brown2rl/MRV32-Platform/Visual Aids/ALU.png

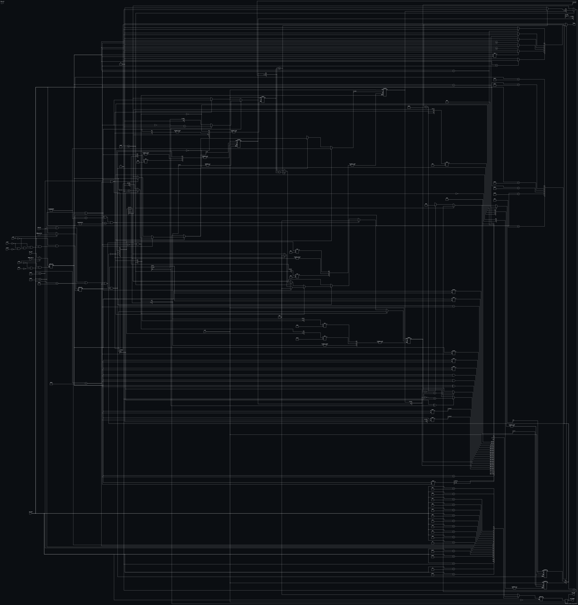
Visual Aids/ALU.png
