brown2rl/MRV32-Platform/Visual Aids/cache_state_diagram.png

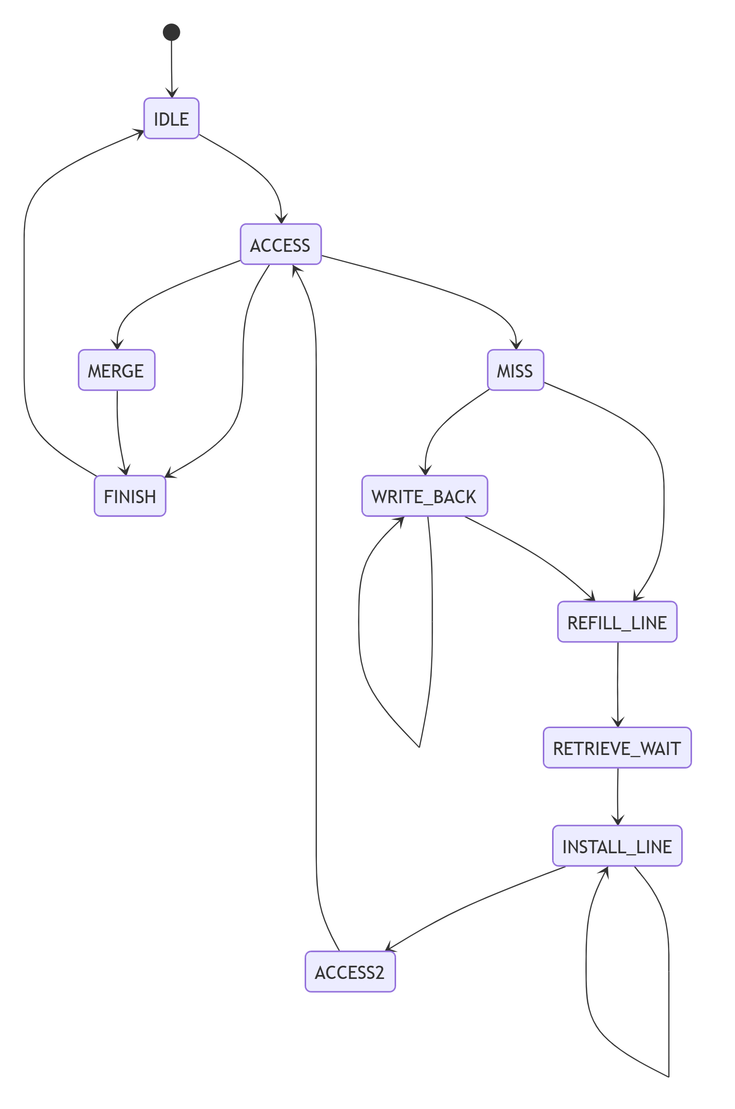
Visual Aids/cache_state_diagram.png
