brown2rl/MRV32-Platform/Visual Aids/CSR Bus.png

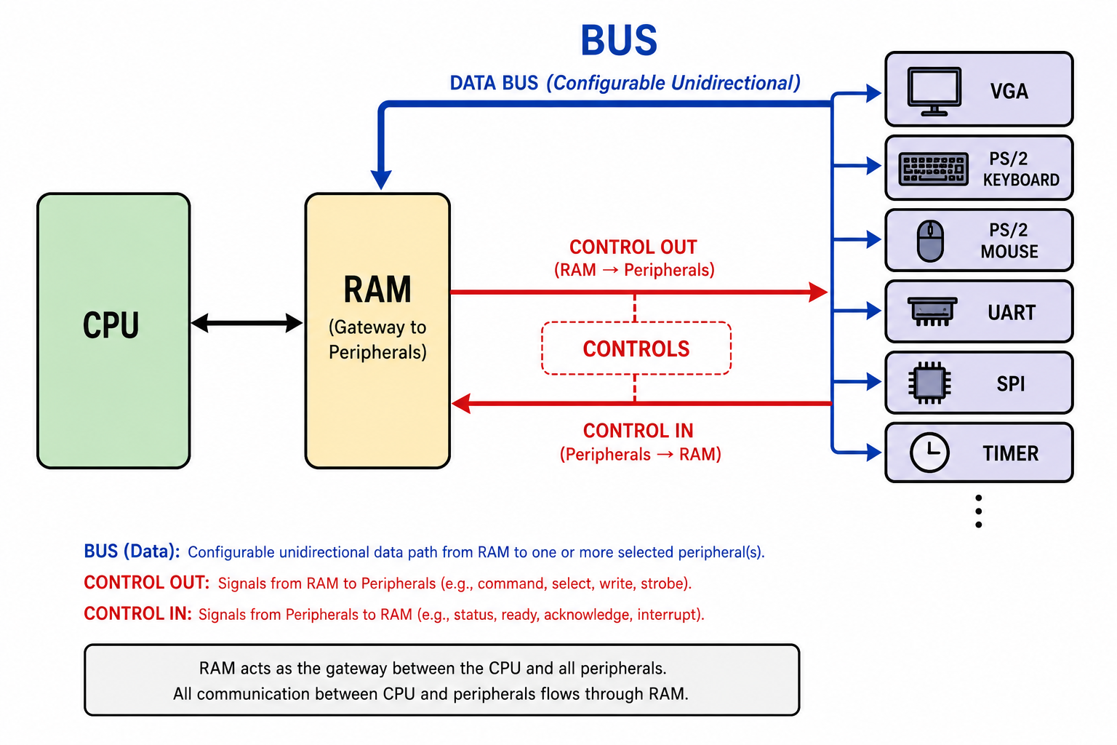
Visual Aids/CSR Bus.png
