brown2rl/MRV32-Platform/Visual Aids/MRV32 Hardware Datapath Diagram.png

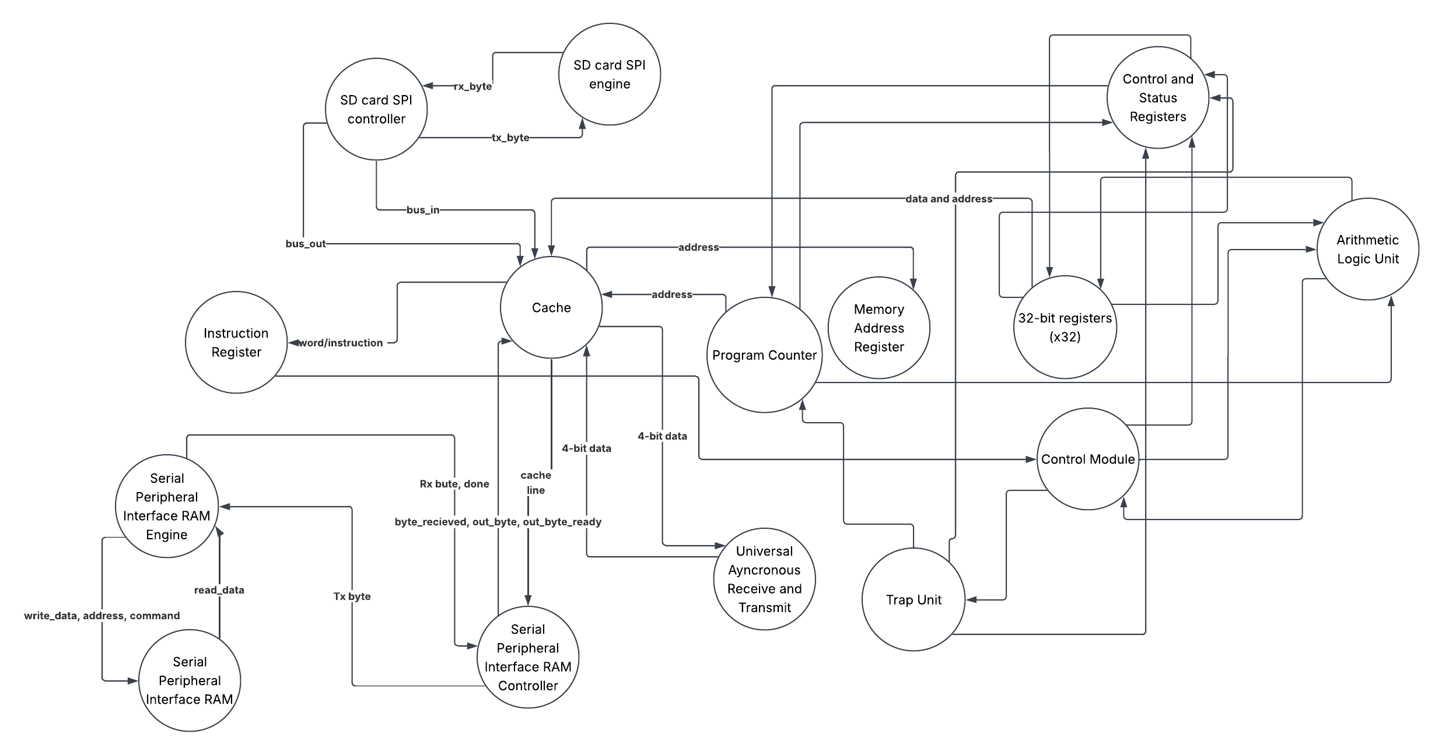
Visual Aids/MRV32 Hardware Datapath Diagram.png
