brown2rl/MRV32-Platform/Visual Aids/Normal_Fetch_Cycle.png

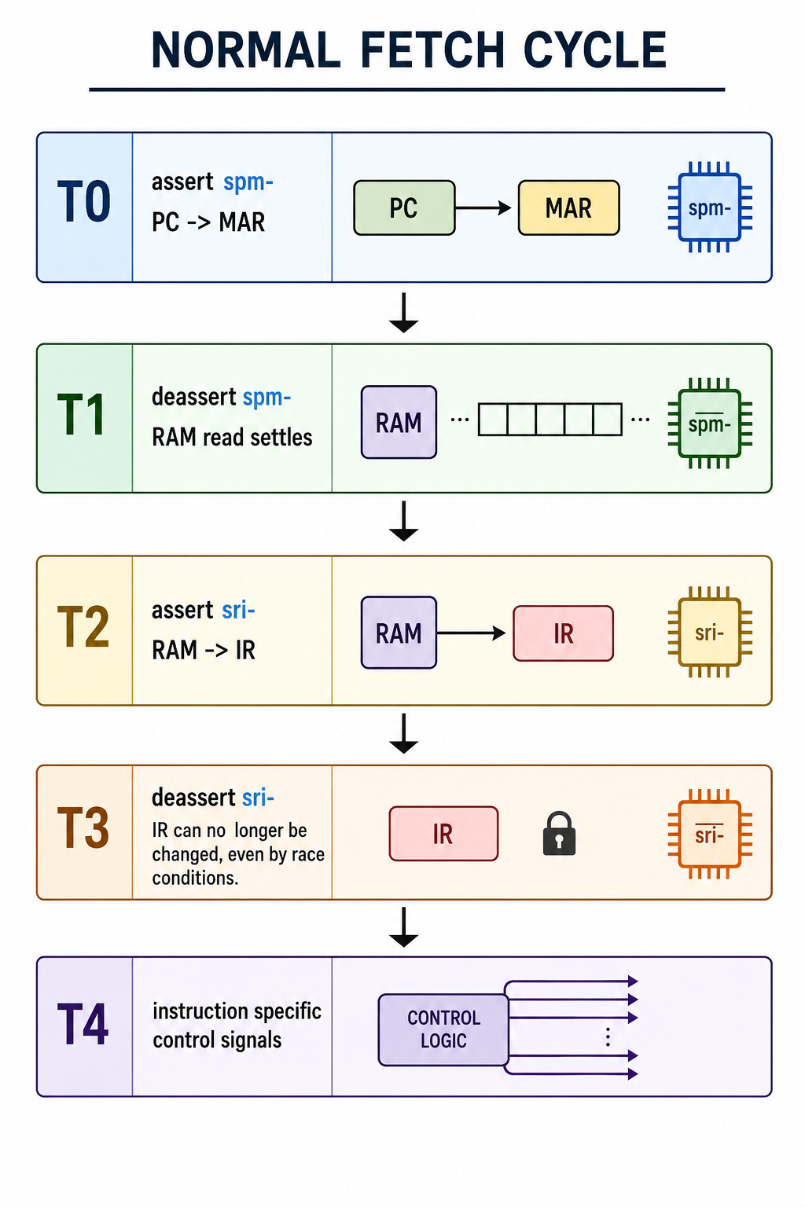
Visual Aids/Normal_Fetch_Cycle.png
