brown2rl/MRV32-Platform/Visual Aids/RISCV.png

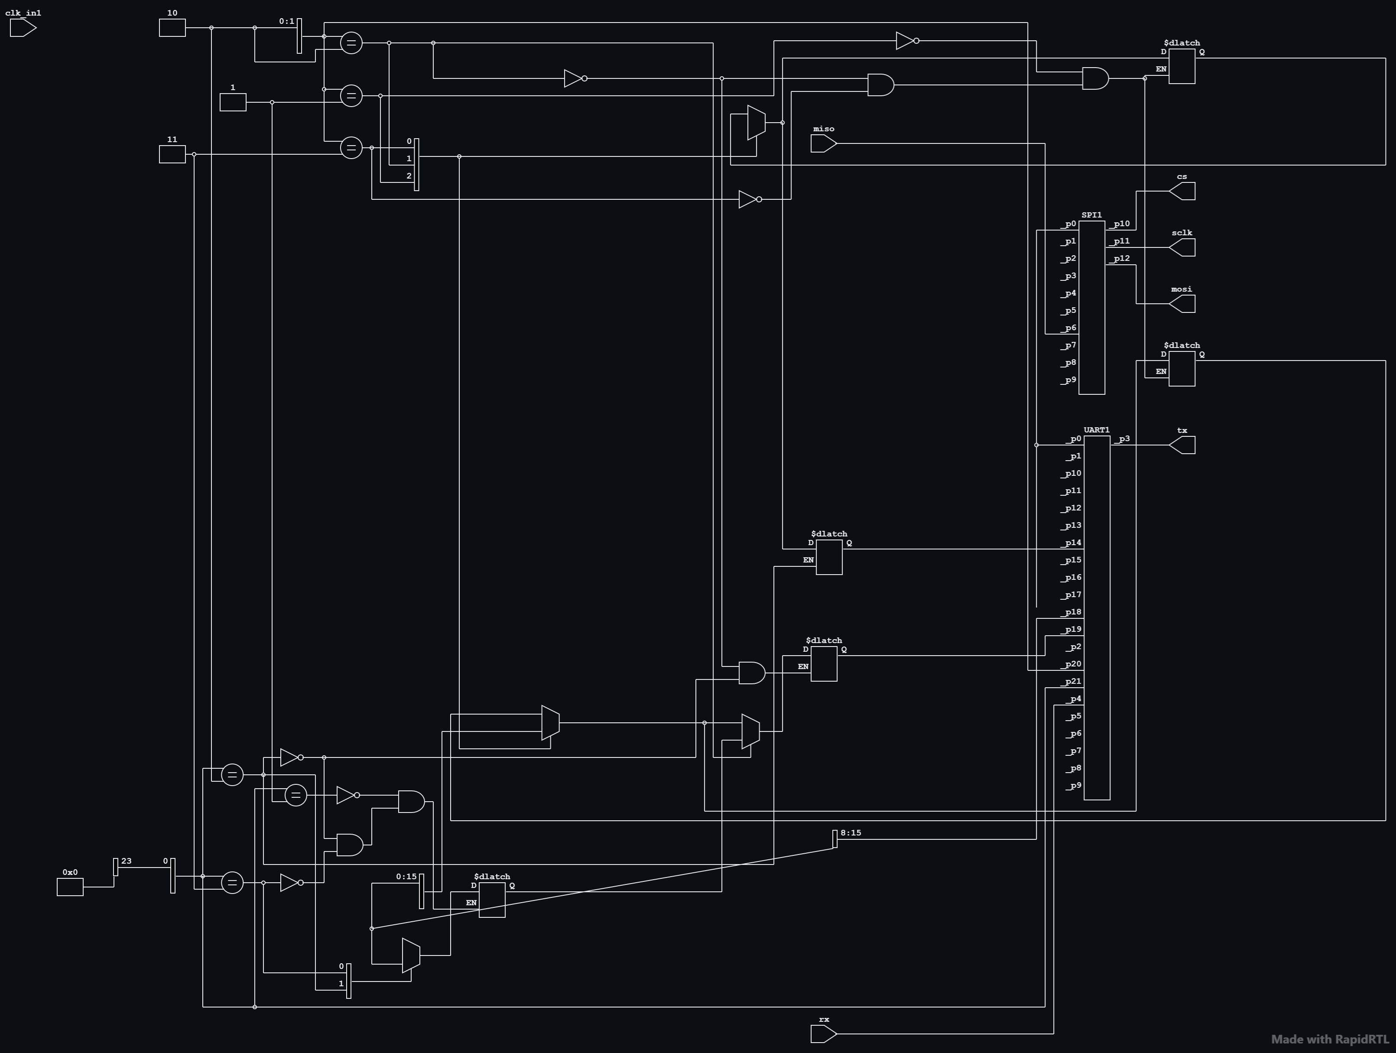
Visual Aids/RISCV.png
