brown2rl/MRV32-Platform/Visual Aids/spi_diagrams/spiram_command_decoder.png

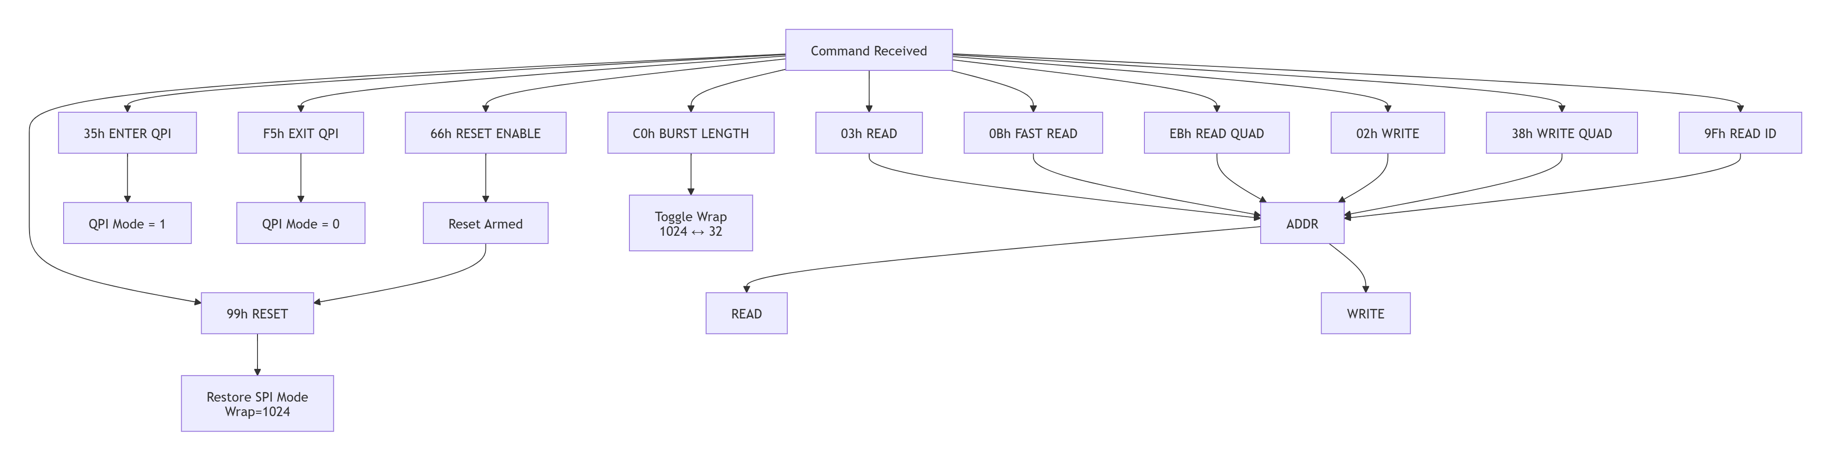
Visual Aids/spi_diagrams/spiram_command_decoder.png
