brown2rl/MRV32-Platform/Visual Aids/spi_diagrams/spiram_controller_fsm.png

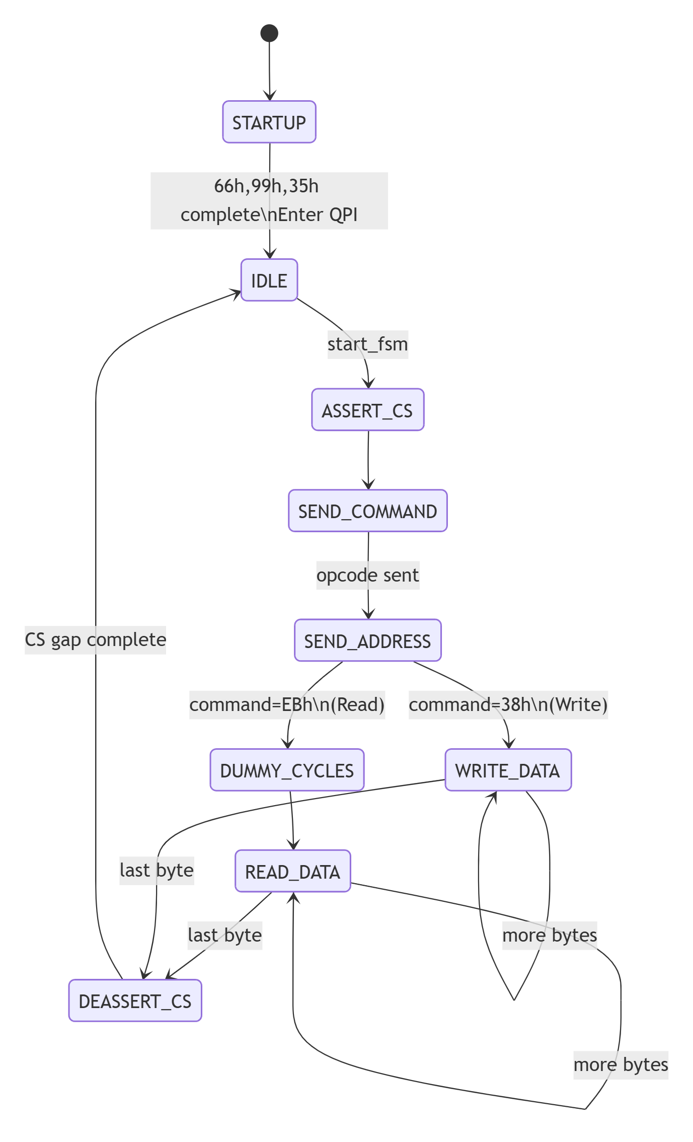
Visual Aids/spi_diagrams/spiram_controller_fsm.png
