brown2rl/MRV32-Platform/Visual Aids/spi_diagrams/spiramcontroller_dataflow.png

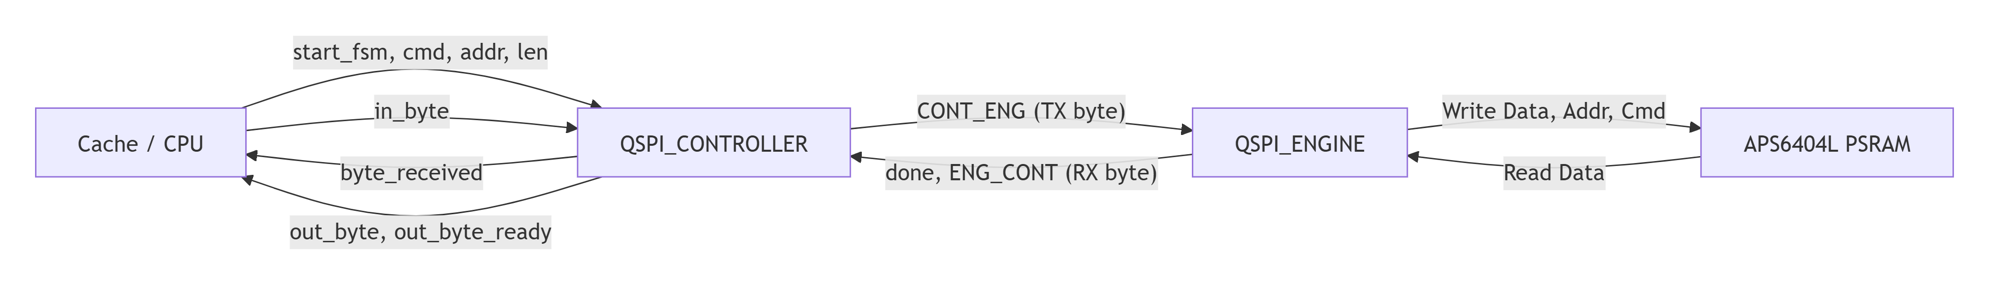
Visual Aids/spi_diagrams/spiramcontroller_dataflow.png
