brown2rl/MRV32-Platform/Visual Aids/Type_R_Instructions.png

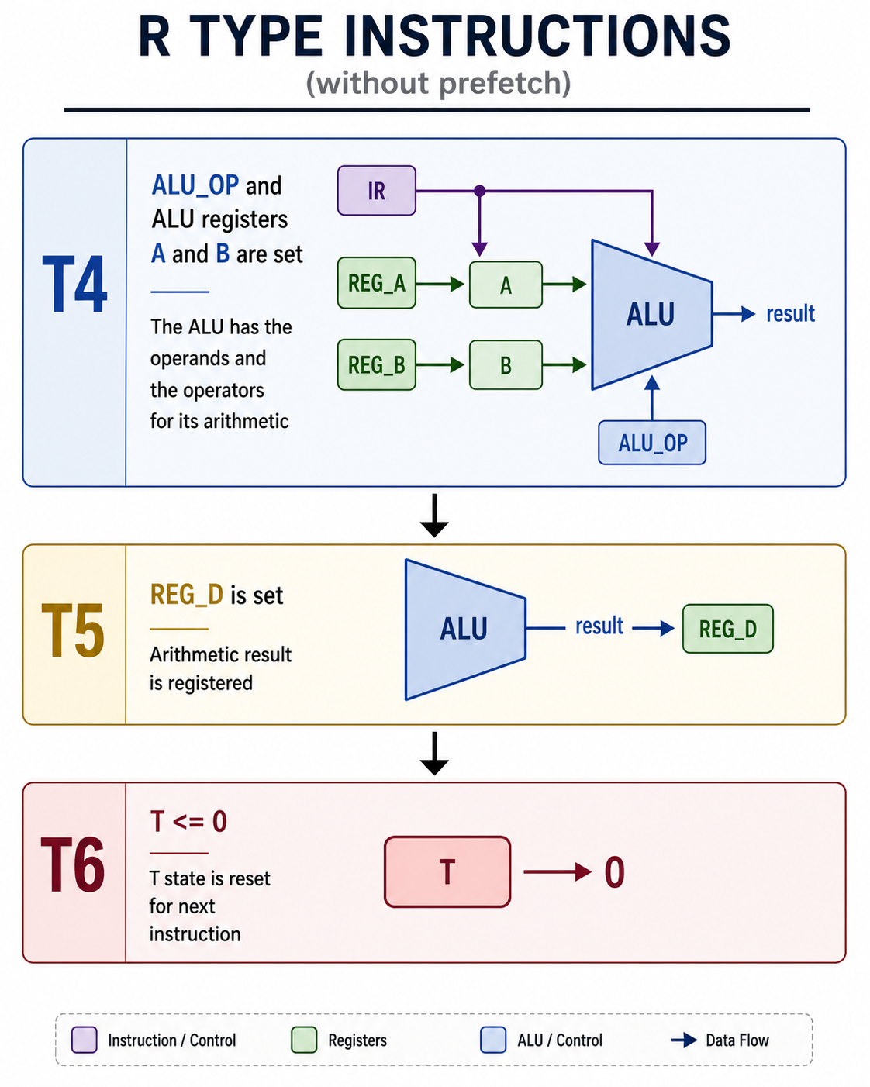
Visual Aids/Type_R_Instructions.png
