brown2rl/MRV32-Platform/Soft Core/uart_const.xdc

## This file is a general .xdc for the Basys3 rev B board
## To use it in a project:
## - uncomment the lines corresponding to used pins
## - rename the used ports (in each line, after get_ports) according to the top level signal names in the project

## Clock signal
set_property -dict {PACKAGE_PIN W5 IOSTANDARD LVCMOS33} [get_ports clk_in1]
create_clock -period 10.000 -name sys_clk_pin -waveform {0.000 5.000} -add [get_ports clk_in1]


## Switches
#set_property -dict { PACKAGE_PIN V17   IOSTANDARD LVCMOS33 } [get_ports in0]
#set_property -dict { PACKAGE_PIN V16   IOSTANDARD LVCMOS33 } [get_ports {sw[1]}]
#set_property -dict { PACKAGE_PIN W16   IOSTANDARD LVCMOS33 } [get_ports {sw[2]}]
#set_property -dict { PACKAGE_PIN W17   IOSTANDARD LVCMOS33 } [get_ports {sw[3]}]
#set_property -dict { PACKAGE_PIN W15   IOSTANDARD LVCMOS33 } [get_ports {sw[4]}]
#set_property -dict { PACKAGE_PIN V15   IOSTANDARD LVCMOS33 } [get_ports {sw[5]}]
#set_property -dict { PACKAGE_PIN W14   IOSTANDARD LVCMOS33 } [get_ports {sw[6]}]
#set_property -dict { PACKAGE_PIN W13   IOSTANDARD LVCMOS33 } [get_ports {sw[7]}]
#set_property -dict { PACKAGE_PIN V2    IOSTANDARD LVCMOS33 } [get_ports {sw[8]}]
#set_property -dict { PACKAGE_PIN T3    IOSTANDARD LVCMOS33 } [get_ports {sw[9]}]
#set_property -dict { PACKAGE_PIN T2    IOSTANDARD LVCMOS33 } [get_ports {sw[10]}]
#set_property -dict { PACKAGE_PIN R3    IOSTANDARD LVCMOS33 } [get_ports {sw[11]}]
#set_property -dict { PACKAGE_PIN W2    IOSTANDARD LVCMOS33 } [get_ports {sw[12]}]
#set_property -dict { PACKAGE_PIN U1    IOSTANDARD LVCMOS33 } [get_ports {sw[13]}]
#set_property -dict { PACKAGE_PIN T1    IOSTANDARD LVCMOS33 } [get_ports {sw[14]}]
#set_property -dict { PACKAGE_PIN R2    IOSTANDARD LVCMOS33 } [get_ports {sw[15]}]


## LEDs
set_property -dict {PACKAGE_PIN U16 IOSTANDARD LVCMOS33} [get_ports out0]
set_property -dict {PACKAGE_PIN E19 IOSTANDARD LVCMOS33} [get_ports out1]
set_property -dict {PACKAGE_PIN U19 IOSTANDARD LVCMOS33} [get_ports out2]
set_property -dict {PACKAGE_PIN V19 IOSTANDARD LVCMOS33} [get_ports out3]
set_property -dict {PACKAGE_PIN W18 IOSTANDARD LVCMOS33} [get_ports out4]
set_property -dict {PACKAGE_PIN U15 IOSTANDARD LVCMOS33} [get_ports out5]
set_property -dict {PACKAGE_PIN U14 IOSTANDARD LVCMOS33} [get_ports out6]
set_property -dict {PACKAGE_PIN V14 IOSTANDARD LVCMOS33} [get_ports out7]
set_property -dict {PACKAGE_PIN V13 IOSTANDARD LVCMOS33} [get_ports out8]
set_property -dict {PACKAGE_PIN V3 IOSTANDARD LVCMOS33} [get_ports out9]
set_property -dict {PACKAGE_PIN W3 IOSTANDARD LVCMOS33} [get_ports out10]
set_property -dict {PACKAGE_PIN U3 IOSTANDARD LVCMOS33} [get_ports out11]
set_property -dict {PACKAGE_PIN P3 IOSTANDARD LVCMOS33} [get_ports out12]
set_property -dict {PACKAGE_PIN N3 IOSTANDARD LVCMOS33} [get_ports out13]
set_property -dict {PACKAGE_PIN P1 IOSTANDARD LVCMOS33} [get_ports out14]
set_property -dict {PACKAGE_PIN L1 IOSTANDARD LVCMOS33} [get_ports ss]


##7 Segment Display
#set_property -dict { PACKAGE_PIN W7   IOSTANDARD LVCMOS33 } [get_ports {seg[0]}]
#set_property -dict { PACKAGE_PIN W6   IOSTANDARD LVCMOS33 } [get_ports {seg[1]}]
#set_property -dict { PACKAGE_PIN U8   IOSTANDARD LVCMOS33 } [get_ports {seg[2]}]
#set_property -dict { PACKAGE_PIN V8   IOSTANDARD LVCMOS33 } [get_ports {seg[3]}]
#set_property -dict { PACKAGE_PIN U5   IOSTANDARD LVCMOS33 } [get_ports {seg[4]}]
#set_property -dict { PACKAGE_PIN V5   IOSTANDARD LVCMOS33 } [get_ports {seg[5]}]
#set_property -dict { PACKAGE_PIN U7   IOSTANDARD LVCMOS33 } [get_ports {seg[6]}]

#set_property -dict { PACKAGE_PIN V7   IOSTANDARD LVCMOS33 } [get_ports dp]

#set_property -dict { PACKAGE_PIN U2   IOSTANDARD LVCMOS33 } [get_ports {an[0]}]
#set_property -dict { PACKAGE_PIN U4   IOSTANDARD LVCMOS33 } [get_ports {an[1]}]
#set_property -dict { PACKAGE_PIN V4   IOSTANDARD LVCMOS33 } [get_ports {an[2]}]
#set_property -dict { PACKAGE_PIN W4   IOSTANDARD LVCMOS33 } [get_ports {an[3]}]


##Buttons
set_property -dict {PACKAGE_PIN U18 IOSTANDARD LVCMOS33} [get_ports rst]
#set_property -dict { PACKAGE_PIN T18   IOSTANDARD LVCMOS33 } [get_ports btnU]
set_property -dict {PACKAGE_PIN W19 IOSTANDARD LVCMOS33} [get_ports rstc]
set_property -dict {PACKAGE_PIN T17 IOSTANDARD LVCMOS33} [get_ports in0]
#set_property -dict { PACKAGE_PIN U17   IOSTANDARD LVCMOS33 } [get_ports btnD]


##Pmod Header JA
#set_property -dict { PACKAGE_PIN J1   IOSTANDARD LVCMOS33 } [get_ports {JA[0]}];#Sch name = JA1
#set_property -dict { PACKAGE_PIN L2   IOSTANDARD LVCMOS33 } [get_ports {JA[1]}];#Sch name = JA2
#set_property -dict { PACKAGE_PIN J2   IOSTANDARD LVCMOS33 } [get_ports {JA[2]}];#Sch name = JA3
#set_property -dict { PACKAGE_PIN G2   IOSTANDARD LVCMOS33 } [get_ports {JA[3]}];#Sch name = JA4
#set_property -dict { PACKAGE_PIN H1   IOSTANDARD LVCMOS33 } [get_ports {JA[4]}];#Sch name = JA7
#set_property -dict { PACKAGE_PIN K2   IOSTANDARD LVCMOS33 } [get_ports {JA[5]}];#Sch name = JA8
#set_property -dict { PACKAGE_PIN H2   IOSTANDARD LVCMOS33 } [get_ports {JA[6]}];#Sch name = JA9
#set_property -dict { PACKAGE_PIN G3   IOSTANDARD LVCMOS33 } [get_ports {JA[7]}];#Sch name = JA10

## Pmod Header JB (Top Row mapping)
# Pin 1 - JB1 - Chip Select (Pulled UP)
set_property PACKAGE_PIN A14 [get_ports cs]
set_property IOSTANDARD LVCMOS33 [get_ports cs]
set_property PULLTYPE PULLUP [get_ports cs]

# Pin 2 - JB2 - MOSI (Output)
set_property -dict {PACKAGE_PIN A16 IOSTANDARD LVCMOS33} [get_ports mosi]

# Pin 3 - JB3 - MISO (Input, Pulled UP)
set_property PACKAGE_PIN B15 [get_ports miso]
set_property IOSTANDARD LVCMOS33 [get_ports miso]
set_property PULLTYPE PULLUP [get_ports miso]

# Pin 4 - JB4 - SCLK (Output)
set_property -dict {PACKAGE_PIN B16 IOSTANDARD LVCMOS33} [get_ports sclk]

##Pmod Header JC
#set_property -dict { PACKAGE_PIN K17   IOSTANDARD LVCMOS33 } [get_ports {JC[0]}];#Sch name = JC1
#set_property -dict { PACKAGE_PIN M18   IOSTANDARD LVCMOS33 } [get_ports {JC[1]}];#Sch name = JC2
#set_property -dict { PACKAGE_PIN N17   IOSTANDARD LVCMOS33 } [get_ports {JC[2]}];#Sch name = JC3
#set_property -dict { PACKAGE_PIN P18   IOSTANDARD LVCMOS33 } [get_ports {JC[3]}];#Sch name = JC4
#set_property -dict { PACKAGE_PIN L17   IOSTANDARD LVCMOS33 } [get_ports {JC[4]}];#Sch name = JC7
#set_property -dict { PACKAGE_PIN M19   IOSTANDARD LVCMOS33 } [get_ports {JC[5]}];#Sch name = JC8
#set_property -dict { PACKAGE_PIN P17   IOSTANDARD LVCMOS33 } [get_ports {JC[6]}];#Sch name = JC9
#set_property -dict { PACKAGE_PIN R18   IOSTANDARD LVCMOS33 } [get_ports {JC[7]}];#Sch name = JC10

##Pmod Header JXADC
#set_property -dict { PACKAGE_PIN J3   IOSTANDARD LVCMOS33 } [get_ports {JXADC[0]}];#Sch name = XA1_P
#set_property -dict { PACKAGE_PIN L3   IOSTANDARD LVCMOS33 } [get_ports {JXADC[1]}];#Sch name = XA2_P
#set_property -dict { PACKAGE_PIN M2   IOSTANDARD LVCMOS33 } [get_ports {JXADC[2]}];#Sch name = XA3_P
#set_property -dict { PACKAGE_PIN N2   IOSTANDARD LVCMOS33 } [get_ports {JXADC[3]}];#Sch name = XA4_P
#set_property -dict { PACKAGE_PIN K3   IOSTANDARD LVCMOS33 } [get_ports {JXADC[4]}];#Sch name = XA1_N
#set_property -dict { PACKAGE_PIN M3   IOSTANDARD LVCMOS33 } [get_ports {JXADC[5]}];#Sch name = XA2_N
#set_property -dict { PACKAGE_PIN M1   IOSTANDARD LVCMOS33 } [get_ports {JXADC[6]}];#Sch name = XA3_N
#set_property -dict { PACKAGE_PIN N1   IOSTANDARD LVCMOS33 } [get_ports {JXADC[7]}];#Sch name = XA4_N


##VGA Connector
#set_property -dict { PACKAGE_PIN G19   IOSTANDARD LVCMOS33 } [get_ports {vgaRed[0]}]
#set_property -dict { PACKAGE_PIN H19   IOSTANDARD LVCMOS33 } [get_ports {vgaRed[1]}]
#set_property -dict { PACKAGE_PIN J19   IOSTANDARD LVCMOS33 } [get_ports {vgaRed[2]}]
#set_property -dict { PACKAGE_PIN N19   IOSTANDARD LVCMOS33 } [get_ports {vgaRed[3]}]
#set_property -dict { PACKAGE_PIN N18   IOSTANDARD LVCMOS33 } [get_ports {vgaBlue[0]}]
#set_property -dict { PACKAGE_PIN L18   IOSTANDARD LVCMOS33 } [get_ports {vgaBlue[1]}]
#set_property -dict { PACKAGE_PIN K18   IOSTANDARD LVCMOS33 } [get_ports {vgaBlue[2]}]
#set_property -dict { PACKAGE_PIN J18   IOSTANDARD LVCMOS33 } [get_ports {vgaBlue[3]}]
#set_property -dict { PACKAGE_PIN J17   IOSTANDARD LVCMOS33 } [get_ports {vgaGreen[0]}]
#set_property -dict { PACKAGE_PIN H17   IOSTANDARD LVCMOS33 } [get_ports {vgaGreen[1]}]
#set_property -dict { PACKAGE_PIN G17   IOSTANDARD LVCMOS33 } [get_ports {vgaGreen[2]}]
#set_property -dict { PACKAGE_PIN D17   IOSTANDARD LVCMOS33 } [get_ports {vgaGreen[3]}]
#set_property -dict { PACKAGE_PIN P19   IOSTANDARD LVCMOS33 } [get_ports Hsync]
#set_property -dict { PACKAGE_PIN R19   IOSTANDARD LVCMOS33 } [get_ports Vsync]


##USB-RS232 Interface
set_property -dict {PACKAGE_PIN B18 IOSTANDARD LVCMOS33} [get_ports rx]
set_property -dict {PACKAGE_PIN A18 IOSTANDARD LVCMOS33} [get_ports tx]


##USB HID (PS/2)
#set_property -dict { PACKAGE_PIN C17   IOSTANDARD LVCMOS33   PULLUP true } [get_ports PS2Clk]
#set_property -dict { PACKAGE_PIN B17   IOSTANDARD LVCMOS33   PULLUP true } [get_ports PS2Data]


##Quad SPI Flash
##Note that CCLK_0 cannot be placed in 7 series devices. You can access it using the
##STARTUPE2 primitive.
#set_property -dict { PACKAGE_PIN D18   IOSTANDARD LVCMOS33 } [get_ports {QspiDB[0]}]
#set_property -dict { PACKAGE_PIN D19   IOSTANDARD LVCMOS33 } [get_ports {QspiDB[1]}]
#set_property -dict { PACKAGE_PIN G18   IOSTANDARD LVCMOS33 } [get_ports {QspiDB[2]}]
#set_property -dict { PACKAGE_PIN F18   IOSTANDARD LVCMOS33 } [get_ports {QspiDB[3]}]
#set_property -dict { PACKAGE_PIN K19   IOSTANDARD LVCMOS33 } [get_ports QspiCSn]


## Configuration options, can be used for all designs
set_property CONFIG_VOLTAGE 3.3 [current_design]
set_property CFGBVS VCCO [current_design]

## SPI configuration mode options for QSPI boot, can be used for all designs
#set_property BITSTREAM.GENERAL.COMPRESS TRUE [current_design]
#set_property BITSTREAM.CONFIG.CONFIGRATE 33 [current_design]
#set_property CONFIG_MODE SPIx4 [current_design]


#set_property MARK_DEBUG false [get_nets {CM_REGS[1]}]
#set_property MARK_DEBUG false [get_nets {CM_REGS[0]}]
#set_property MARK_DEBUG false [get_nets {CM_REGS[2]}]
#set_property MARK_DEBUG false [get_nets {CM_REGS[3]}]
#set_property MARK_DEBUG false [get_nets {CM_REGS[4]}]
#set_property MARK_DEBUG false [get_nets {CM_REGS[20]}]
#set_property MARK_DEBUG false [get_nets {CM_REGS[23]}]
#set_property MARK_DEBUG false [get_nets {CM_REGS[29]}]
#set_property MARK_DEBUG false [get_nets {CM_REGS[22]}]
#set_property MARK_DEBUG false [get_nets {CM_REGS[21]}]
#set_property MARK_DEBUG false [get_nets {CM_REGS[5]}]
#set_property MARK_DEBUG false [get_nets {CM_REGS[14]}]
#set_property MARK_DEBUG false [get_nets {CM_REGS[30]}]
#set_property MARK_DEBUG false [get_nets {CM_REGS[25]}]
#set_property MARK_DEBUG false [get_nets {CM_REGS[6]}]
#set_property MARK_DEBUG false [get_nets {CM_REGS[7]}]
#set_property MARK_DEBUG false [get_nets {CM_REGS[24]}]
#set_property MARK_DEBUG false [get_nets {CM_REGS[26]}]
#set_property MARK_DEBUG false [get_nets {CM_REGS[13]}]
#set_property MARK_DEBUG false [get_nets {CM_REGS[8]}]
#set_property MARK_DEBUG false [get_nets {CM_REGS[11]}]
#set_property MARK_DEBUG false [get_nets {CM_REGS[17]}]
#set_property MARK_DEBUG false [get_nets {CM_REGS[27]}]
#set_property MARK_DEBUG false [get_nets {CM_REGS[19]}]
#set_property MARK_DEBUG false [get_nets {CM_REGS[15]}]
#set_property MARK_DEBUG false [get_nets {CM_REGS[18]}]
#set_property MARK_DEBUG false [get_nets {CM_REGS[16]}]
#set_property MARK_DEBUG false [get_nets {CM_REGS[9]}]
#set_property MARK_DEBUG false [get_nets {CM_REGS[12]}]
#set_property MARK_DEBUG false [get_nets {CM_REGS[10]}]
#set_property MARK_DEBUG false [get_nets {CM_REGS[31]}]
#set_property MARK_DEBUG false [get_nets {CM_REGS[28]}]

#set_property MARK_DEBUG false [get_nets out8_OBUF]

#set_property MARK_DEBUG true [get_nets PC1/out10]
#connect_debug_port u_ila_0/probe0 [get_nets [list PC1/out10]]

#set_property MARK_DEBUG false [get_nets {REG_D[0]}]
#set_property MARK_DEBUG false [get_nets {REG_D[1]}]
#set_property MARK_DEBUG false [get_nets {REG_D[2]}]
#set_property MARK_DEBUG false [get_nets {REG_D[3]}]
#set_property MARK_DEBUG false [get_nets {REG_D[4]}]




set_property MARK_DEBUG false [get_nets cs_OBUF]
set_property MARK_DEBUG false [get_nets sclk_OBUF]


set_property MARK_DEBUG true [get_nets ss_OBUF]







connect_debug_port u_ila_0/clk [get_nets [list CW1/inst/clk_out1]]
connect_debug_port u_ila_0/probe3 [get_nets [list ss_OBUF]]

set_property MARK_DEBUG false [get_nets miso_IBUF]
set_property MARK_DEBUG false [get_nets mosi_OBUF]



create_debug_core u_ila_0 ila
set_property ALL_PROBE_SAME_MU true [get_debug_cores u_ila_0]
set_property ALL_PROBE_SAME_MU_CNT 1 [get_debug_cores u_ila_0]
set_property C_ADV_TRIGGER false [get_debug_cores u_ila_0]
set_property C_DATA_DEPTH 65536 [get_debug_cores u_ila_0]
set_property C_EN_STRG_QUAL false [get_debug_cores u_ila_0]
set_property C_INPUT_PIPE_STAGES 0 [get_debug_cores u_ila_0]
set_property C_TRIGIN_EN false [get_debug_cores u_ila_0]
set_property C_TRIGOUT_EN false [get_debug_cores u_ila_0]
set_property port_width 1 [get_debug_ports u_ila_0/clk]
connect_debug_port u_ila_0/clk [get_nets [list CW1/inst/clk_out1]]
set_property PROBE_TYPE DATA_AND_TRIGGER [get_debug_ports u_ila_0/probe0]
set_property port_width 1 [get_debug_ports u_ila_0/probe0]
connect_debug_port u_ila_0/probe0 [get_nets [list miso_IBUF]]
create_debug_port u_ila_0 probe
set_property PROBE_TYPE DATA_AND_TRIGGER [get_debug_ports u_ila_0/probe1]
set_property port_width 1 [get_debug_ports u_ila_0/probe1]
connect_debug_port u_ila_0/probe1 [get_nets [list sclk_OBUF]]
create_debug_port u_ila_0 probe
set_property PROBE_TYPE DATA_AND_TRIGGER [get_debug_ports u_ila_0/probe2]
set_property port_width 1 [get_debug_ports u_ila_0/probe2]
connect_debug_port u_ila_0/probe2 [get_nets [list SDC1/ss]]
create_debug_port u_ila_0 probe
set_property PROBE_TYPE DATA_AND_TRIGGER [get_debug_ports u_ila_0/probe3]
set_property port_width 1 [get_debug_ports u_ila_0/probe3]
connect_debug_port u_ila_0/probe3 [get_nets [list mosi_OBUF]]
set_property C_CLK_INPUT_FREQ_HZ 300000000 [get_debug_cores dbg_hub]
set_property C_ENABLE_CLK_DIVIDER false [get_debug_cores dbg_hub]
set_property C_USER_SCAN_CHAIN 1 [get_debug_cores dbg_hub]
connect_debug_port dbg_hub/clk [get_nets clk_out1]
