brown2rl/MRV32-Platform/Soft Core/CM.v

module CM(clk, rst, tu, restu, ecall, sret, mret, tuwfi, rxinterrupt, tx_int_ack, dev_start_signal, dev_stop_signal, sdevram, sdrs, sdrd, sdws, sdwd, spp, ssp, srs, pc, bacm, stucsrpc, pcpi, ipc, mpi, rpi, scmcsi, scmcst, scmpc, jalr, cur, smi, spm, srm, crm, sri, spcr, spcrt, srpc, spca, sraa, srab, sar, scmr, srcm, srram, srr8, srr16, srr32, sramrs8, sramrs16, sramrs32, sramru8, sramru16, scsr, srcs, spcs, scsp, scmcs, csbmr, csbmi, csor, csori, csan, csrl, csani, smrar, scma, scmau, stupc, ALU_OP, CM_PC, IR_CM, REGS_CM, CM_REGS, REG_A, REG_B, REG_D, CM_ALU, ALU_CM, CM_CSR, CM_CSRI, CM_CSRT, CM_MAR, CSR_DEV_BUS_IN, CSR_DEV_BUS_OUT);

input clk, rst, bacm, stucsrpc, stupc, rxinterrupt, tx_int_ack, dev_stop_signal, sdrd, sdwd;
input[31:0] IR_CM, REGS_CM, ALU_CM, CSR_DEV_BUS_IN, CSR_DEV_BUS_OUT;
output reg[31:0] CM_REGS, CM_CSRI, CM_CSRT;
output reg[11:0] CM_CSR;
output reg[19:0] CM_PC;
output reg[31:0] CM_MAR;
output reg[31:0] CM_ALU;
output reg[4:0] REG_A, REG_B, REG_D, ALU_OP;
output reg tu, tuwfi, restu, ecall, sret, mret, sdrs, sdws, srs, pc, pcpi, mpi, rpi, ipc, sdevram, scmcsi, scmcst, scmpc, jalr, cur, spp, ssp, smi, spm, srm, crm, sri, spcr, spcrt, srpc, spca, sraa, srab, sar, scmr, srcm, srram, srr8, srr16, srr32, sramrs8, sramrs16, sramrs32, sramru8, sramru16, scsr, srcs, spcs, scsp, scmcs, csbmr, csbmi, csor, csori, csan, csrl, csani, smrar, scma, scmau, dev_start_signal;
wire[31:0] instruction;
reg[5:0] T;
reg[16:0] scounter;
reg wfi_irq, wfi_dev, resT, sup, pf, ri;
wire wfi = wfi_irq | wfi_dev;
localparam [4:0]
    add  = 5'd1,
    mul  = 5'd2,
    XOR  = 5'd3,
    OR   = 5'd4,
    AND  = 5'd5,
    sll  = 5'd6,
    srl  = 5'd7,
    sra  = 5'd8,
    sub  = 5'd9,
    sllr = 5'd10,
    srlr = 5'd11,
    srar = 5'd12,
    lt   = 5'd13,
    ltu  = 5'd14,
    beq  = 5'd15,
    bneq = 5'd16,
    bge  = 5'd17,
    bgeu = 5'd18,
    blt  = 5'd19,
    bltu = 5'd20,
    mulh = 5'd21,
    mulhsu = 5'd22,
    mulhu = 5'd23,
    div = 5'd24,
    divu = 5'd25,
    rem  = 5'd26,
    remu = 5'd27;
    
assign instruction = IR_CM;

always @* tuwfi = wfi_irq;   // device stalls are NOT interruptible

initial
begin
	T = 3'b0;
	//resT = 1'b1;
	wfi_irq = 1'b0;
	wfi_dev = 1'b0;
	REG_A	= 0;	
	REG_B	= 0;
	REG_D	= 0;
	CM_REGS = 0;
    	CM_CSR  = 0;
    	CM_CSRI = 0;
    	CM_CSRT = 0;
    	CM_PC   = 0;
   	CM_MAR  = 0;
    	CM_ALU  = 0;
    	ALU_OP  = 0;
    	sdevram	= 0;
	sret	= 0;
	mret	= 0;
	srs	= 0;
	ssp	= 0;
	sdrs	= 0;
	sdws	= 0;
	ri	= 0;
	pf	= 0;
	tu	= 0;	
	restu    = 0;
	pc 	= 0;
	pcpi	= 0;
	mpi	= 0;
	rpi	= 0;
	scmpc	= 0;
	jalr	= 0;
	cur	= 0;
	smi	= 0;
	spm	= 0;
	srm	= 0;	
	crm 	= 0;
	ipc	= 0;
	sri	= 0;
	spcr	= 0;
	srpc	= 0;
	spca	= 0;
	sraa	= 0;
	srab	= 0;
	sar	= 0;
	scmr	= 0;
	srcm	= 0;
	srram	= 0;
	srr8	= 0;
	srr16	= 0;
	srr32	= 0;
	sramrs8	= 0;
	sramrs16= 0;
	sramrs32= 0;
	sramru8	= 0;
	sramru16= 0;
	scsr	= 0;
	srcs	= 0;
	spcs	= 0;
	scsp	= 0;
	scmcs	= 0;
	csbmr	= 0;
	csbmi	= 0;
	csor	= 0;
	csan	= 0;
	csrl	= 0;
	smrar	= 0;
	scma	= 0;
	scmau	= 0;
	scmcst	= 0;
	resT	= 0;
end

always @(posedge clk)
if (stupc)
begin
    	T <= 0;
    	wfi_irq <= 0;
    	wfi_dev <= 0;
end
else if (rxinterrupt && wfi_irq)
begin
	T <= 0;
	wfi_irq <= 0;
end
else if (tx_int_ack)
begin
    	T <= 0;
    	wfi_irq <= 0;
    	wfi_dev <= 0;
end
else if (wfi_dev && dev_stop_signal)
begin
    	wfi_dev <= 0;
end
else if (!wfi)
begin
    	T <= T + 1;
	if (T == 0 || ri)
	begin
		REG_A	<= 0;	
		REG_B	<= 0;
		REG_D	<= 0;
	    	CM_REGS <= 0;
        	CM_CSR  <= 0;
        	CM_CSRI <= 0;
        	CM_CSRT <= 0;
        	CM_PC   <= 0;
        	CM_MAR  <= 0;
        	CM_ALU  <= 0;
		ALU_OP  <= 0;
		sret	<= 0;
		mret	<= 0;
		ri	<= 0;
		tu	<= 0;	
		restu   <= 0;
		pc 	<= 0;
		pcpi	<= 0;
		mpi	<= 0;
		scmpc	<= 0;
		jalr	<= 0;
		cur 	<= 0;
		smi	<= 0;
		if (!ri)
			spm	<= 1;
		srm	<= 0;	
		crm 	<= 0;
		ipc	<= 0;
		sri	<= 0;
		spcr	<= 0;
		srpc	<= 0;
		spca	<= 0;
		sraa	<= 0;
		srab	<= 0;
		sar	<= 0;
		scmr	<= 0;
		srcm	<= 0;
		srram	<= 0;
		srr8	<= 0;
		srr16	<= 0;
		srr32	<= 0;
		sramrs8	<= 0;
		sramrs16<= 0;
		sramrs32<= 0;
		sramru8	<= 0;
		sramru16<= 0;
		sdevram	<= 0;
		scsr	<= 0;
		srcs	<= 0;
		spcs	<= 0;
		scsp	<= 0;
		scmcs	<= 0;
		csbmr	<= 0;
		csbmi	<= 0;
		csor	<= 0;
		csan	<= 0;
		csrl	<= 0;
		smrar	<= 0;
		scma	<= 0;
		scmau	<= 0;
		scmcst	<= 0;
		resT	<= 0;
	end
	else if (T == 1)
	begin
		spm	<= 0;
	end
	
	else if (T == 2)
	begin
		sri	<= 1;
	end
	else if (T >= 3)
	begin
		sri 	<= 0;
		if (!((instruction[6:0] == 7'b0010111) || (instruction[6:0] == 7'b1110011) || (instruction[6:0] == 7'b0000011) || (instruction[6:0] == 7'b0100011) || (instruction[6:0] == 7'b1101111) || (instruction[6:0] == 7'b1100111) || (instruction[6:0] == 7'b1100011)))
		begin
	
			if (T == 4)
			begin
				pc	<= 1;	
			end
			if (T == 5)
			begin
				spm	<= 1;
				pc	<= 0;
			end
			if (T == 6)
				spm	<= 0;		
		end

		//lui
		if (instruction[6:0] == 7'b0110111)
		begin
		
			REG_D <= instruction[11:7];
			CM_REGS <= { instruction[31:12], 12'b000000000000 };
			scmr <= 0;
			sri <= 0;
			
			if (T == 4)
			begin
				scmr 	<= 1;
			end
			
			if (T >= 7)
			begin
				sri	<= 1;
				T 	<= 3;
				ri	<= 1;
			end
		end
		
		//auipc
		if (instruction[6:0] == 7'b0010111)
		begin
		
			REG_D <= instruction[11:7];
			CM_ALU <= { instruction[31:12], 12'b000000000000 };
			scma 	<= 0;
			spca 	<= 0;
			sar 	<= 0;
			ALU_OP 	<= 0;
			//sri	<= 0;
			
			if  (T == 4)
			begin
				scma 	<= 1;
				spca 	<= 1;
				ALU_OP 	<= add;
			end
			
			if (T == 5)
			begin
				sar 	<= 1;
			end
			
			if (T >= 7)
			begin
				pc	<= 1;
				T 	<= 0;
				//ri	<= 1;
			end
		end
		
		if (instruction[6:0] == 7'b0010011)
		begin
			//addi
			if (instruction[14:12] == 3'b000)
			begin				
			
				REG_D 	<= instruction[11:7];
				REG_A 	<= instruction[19:15];
				CM_ALU 	<= { {20{instruction[31]}}, instruction[31:20] };
                		scma 	<= 0;
                		sraa 	<= 0;
                		ALU_OP 	<= 0;
                		sar  	<= 0;
                		sri   	<= 0;
				
				if (T == 4)
				begin
					scma 	<= 1;
					sraa 	<= 1;
					ALU_OP 	<= add;
				end
				
				else if (T == 5)
				begin
					sar 	<= 1;
			   	end
			    
				else if (T >= 7)
				begin
					sri	<= 1;
					T 	<= 3;
					ri	<= 1;
				end
			end
		
			//slti
			if (instruction[14:12] == 3'b010)
			begin
			
				REG_D 	<= instruction[11:7];
				REG_A 	<= instruction[19:15];
				CM_ALU 	<= { {20{instruction[31]}}, instruction[31:20] };
				scma 	<= 0;
				sraa 	<= 0;
				ALU_OP 	<= 0;
				sar 	<= 0;
				sri	<= 0;
				
				if (T == 4)
				begin
					scma 	<= 1;
					sraa 	<= 1;
					ALU_OP 	<= lt;
				end
				
				if (T == 5)
				begin
					sar	<= 1;
				end
				
				if (T >= 7)
				begin
					sri	<= 1;
					T 	<= 3;
					ri	<= 1;
				end
			end
			
			//sltiu
			if (instruction[14:12] == 3'b011)
			begin
			
				REG_A 	<= instruction[19:15];
				REG_D 	<= instruction[11:7];
				CM_ALU 	<= { {20{instruction[31]}}, instruction[31:20] };
				scmau 	<= 0;
				sraa 	<= 0;
				ALU_OP 	<= 0;
				sar 	<= 0;
				sri	<= 0;
				
				if (T == 4)
				begin
					scmau 	<= 1;
					sraa 	<= 1;
					ALU_OP 	<= ltu;
				end
				
				if (T == 5)
				begin
					sar 	<= 1;
				end
				
				if (T >= 7)
				begin
					sri	<= 1;
					T 	<= 3;
					ri	<= 1;
				end
			end
			
			//xori
			if (instruction[14:12] == 3'b100)
			begin
				
				REG_D 	<= instruction[11:7];
				REG_A 	<= instruction[19:15];
				CM_ALU 	<= { {20{instruction[31]}}, instruction[31:20] };
				scma 	<= 0;
				sraa 	<= 0;
				ALU_OP 	<= 0;
				sar	<= 0;
				sri	<= 0;
				
				if (T == 4)
				begin
					scma 	<= 1;
					sraa 	<= 1;
					ALU_OP 	<= XOR;
				end
				
				if (T == 5)
				begin
					sar 	<= 1;
				end
	
				if (T >= 7)
				begin
					sri	<= 1;
					T 	<= 3;
					ri	<= 1;
				end
			end
			
			//ori
			if (instruction[14:12] == 3'b110)
			begin
			
				REG_D 	<= instruction[11:7];
				REG_A 	<= instruction[19:15];
				CM_ALU 	<= { 20'b0, instruction[31:20] };
				scma 	<= 0;
				sraa 	<= 0;
				ALU_OP 	<= 0;
				sar 	<= 0;
				sri	<= 0;
				
				if (T == 4)
				begin
					scma 	<= 1;
					sraa 	<= 1;
					ALU_OP 	<= OR;
				end
				
				if (T == 5)
				begin
					sar 	<= 1;
				end
				
				if (T >= 7)
				begin
					sri	<= 1;
					T 	<= 3;
					ri	<= 1;
				end
			end
			
			//andi
			if (instruction[14:12] == 3'b111)
			begin
			
				REG_D 	<= instruction[11:7];
				REG_A 	<= instruction[19:15];
				CM_ALU 	<= { 20'b0, instruction[31:20] };
				scma 	<= 0;
				sraa 	<= 0;
				ALU_OP 	<= 0;
				sar 	<= 0;
				sri	<= 0;
				
				if (T == 4)
				begin
					scma 	<= 1;
					sraa 	<= 1;
					ALU_OP 	<= AND;
				end
				
				if (T == 5)
				begin
					sar	<= 1;
				end
				
				if (T >= 7)
				begin
					sri	<= 1;
					T 	<= 3;
					ri	<= 1;
				end	
			end
			
			//slli
			if (instruction[14:12] == 3'b001)
			begin
			
				REG_D 	<= instruction[11:7];
				REG_A 	<= instruction[19:15];
				CM_ALU 	<= { 27'b0, instruction[24:20] };
				scmau 	<= 0;
				sraa 	<= 0;
				ALU_OP 	<= 0;
				sar 	<= 0;
				sri	<= 0;
				
				if (T == 4)
				begin
					scmau 	<= 1;
					sraa 	<= 1;
					ALU_OP 	<= sll;
				end
				
				if (T == 5)
				begin
					sar 	<= 1;
				end
				
				if (T >= 7)
				begin
					sri	<= 1;
					T 	<= 3;
					ri	<= 1;
				end
			end
			
			//srli
			if (instruction[14:12] == 3'b101)
			begin
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
					sraa <= 1;
					ALU_OP <= bge;
				end
				
				if (T >= 5)
				begin
					ALU_OP <= 0;
					if (bacm)
					begin
						T <= 0;
					end
					else
					begin
					    pc <= 1;
					    T <= 0;
				    end
				end
			end
			
			//bltu
			if (instruction[14:12] == 3'b110)
			begin

				REG_A <= instruction[19:15];
				REG_B <= instruction[24:20];
				CM_PC <= { instruction[31] , instruction[7] , instruction[30:25] , instruction[11:8] };
				srab <= 0;
				sraa <= 0;
				ALU_OP <= 0;
				pc <= 0;
				
				
				if (T == 4)
				begin
					srab <= 1;
					sraa <= 1;
					ALU_OP <= bltu;
				end
				
				if (T >= 5)
				begin
					ALU_OP <= 0;
					if (bacm)
					begin
						T <= 0;
					end
					else
					begin
					    pc <= 1;
					    T <= 0;
				    end
				end
			end
			
			//bgeu
			if (instruction[14:12] == 3'b111)
			begin

				REG_A <= instruction[19:15];
				REG_B <= instruction[24:20];
				CM_PC <= { instruction[31] , instruction[7] , instruction[30:25] , instruction[11:8] };
				srab <= 0;
				sraa <= 0;
				ALU_OP <= 0;
				pc <= 0;
				
				
				if (T == 4)
				begin
					srab <= 1;
					sraa <= 1;
					ALU_OP <= bgeu;
				end
				
				if (T >= 5)
				begin
					ALU_OP <= 0;
					if (bacm)
					begin
						T <= 0;
					end
					else
					begin
					    	pc <= 1;
					    	T <= 0;
				    	end
				end
			end
		end
	end		
end

endmodule
