brown2rl/MRV32-Platform/(commit log)

2026-07-31 added instruction register RTL schematic
2026-08-07 fixed some modelsim compilation errors
    [RISCV.v]
2026-08-09 compilation errors: illegal part select for cache address, illegal reference to in_byte
    [CACHE.v]
2026-08-09 modularity for SPI
